diegovfeder/culltive/expo-app/src/image/profile.png

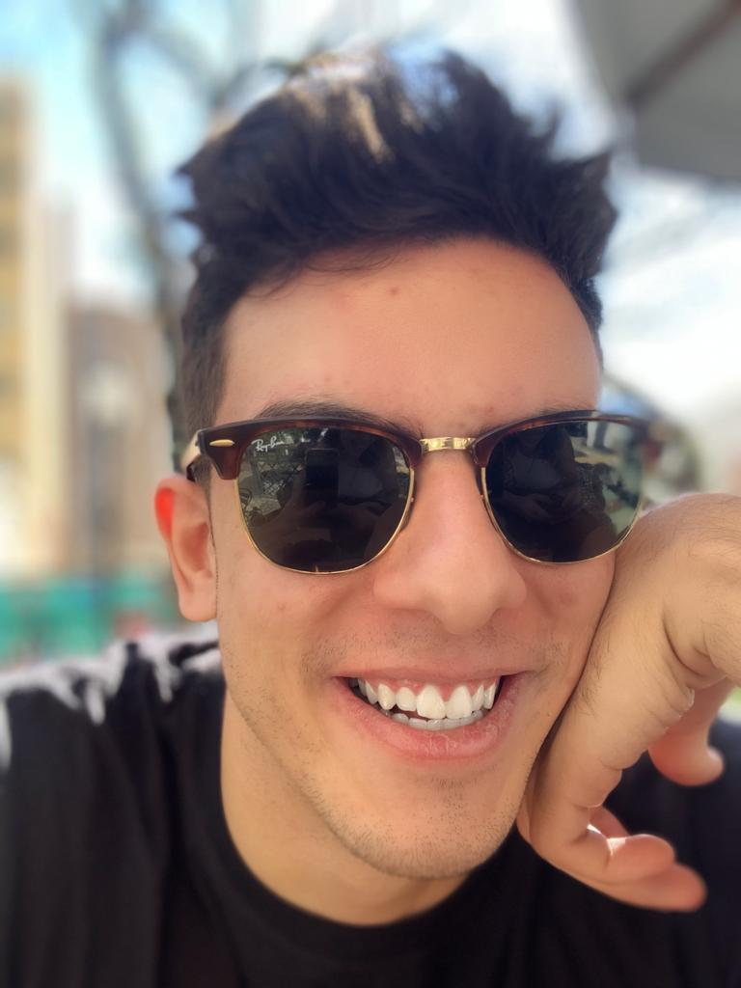
expo-app/src/image/profile.png
