diegovfeder/culltive/expo-app/src/image/acacia3.jpg

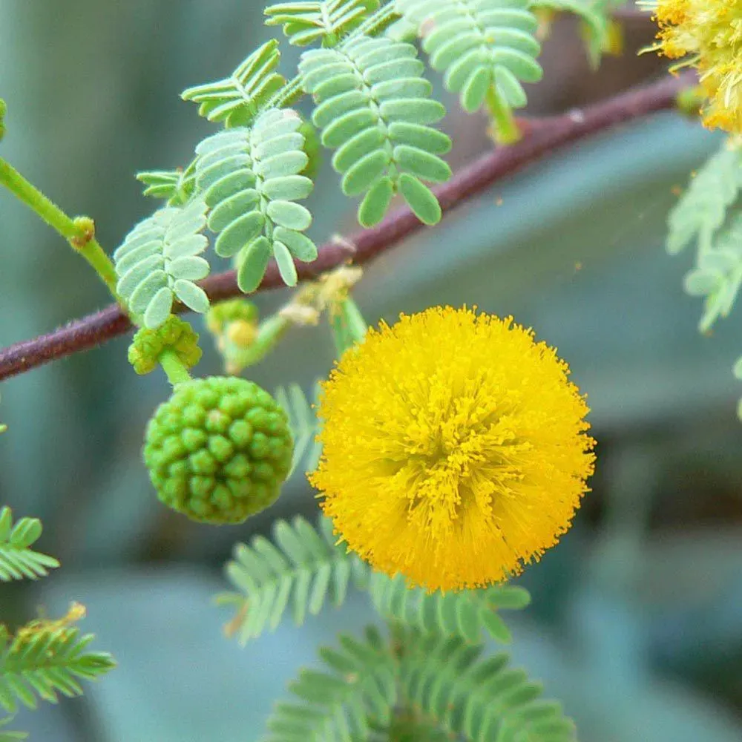
expo-app/src/image/acacia3.jpg
