diegovfeder/culltive/README.md

<h1 align="center">
    Culltive
</h1>

<h4 align="center">
  Culltive is a startup that combines technology, nature and decoration.
</h4>

<p align="center">
    <a href="#-Project">Project</a>&nbsp;&nbsp;&nbsp;|&nbsp;&nbsp;&nbsp;
    <a href="#rocket-Technology">Technology</a>&nbsp;&nbsp;&nbsp;
</p>

<br>

## 💻 Project

It was developed to solve the difficulties of maintaining gardens in urban environments, taking into account unfavorable spaces and the lack of time for the necessary care. 

## :rocket: Technology

This project was developed with the following technologies:

- [React](https://reactjs.org)
- [React Native](https://facebook.github.io/react-native/)
- [Expo](https://expo.io/)
- [Firebase](https://firebase.google.com/)
- [Platform.io](https://platformio.org/)

---
Startup engineered by Diego Feder
