diegovfeder/culltive/.misc/Especies Cultive 10 Agrourb.pdf

CARACTERÍSTICAS INERENTES DAS ESPÉCIES A SEREM UTILIZADAS

NO PROJETO CULTIVE

CURITIBA-PR

2019

SUMÁRIO

### 1 CULTIVE 10

1.1 CEBOLINHA (Allium fistulosum)

Ciclo de vida: perene

Altura máxima: 0,3 metros

Luminosidade: pleno sol e/ou meia sombra

Colheita: 30 dias após o plantio

Profundidade de semeadura: 0,5 cm

Espaçamento:

- Entre sementes – 2 cm
- Entre linhas – 5 cm

Luminosidade adequada: 5 horas de luz

Lux: 2450

FASES (dias): 30

Germinação: 0 – 10.°

Berçário: 11 – 17.°

Crescimento: 18 – 29.°

Colheita: 30.°

1.2 COENTRO (Coriandrum sativum)

Ciclo de vida: anual

Altura máxima: 0,6 metros

Luminosidade: pleno sol e/ou meia sombra

Colheita: 35 dias após o plantio

Profundidade de semeadura: 1,0 cm

Espaçamento:

- Entre sementes – 3 cm

- Entre linhas – 5 cm

Luminosidade adequada: 5 horas de luz

Lux: 2450

FASES (dias): 35

Germinação: 0 – 9.°

Berçário: 10 – 16.°

Crescimento: 17 – 34.°

Colheita: 35.°

1.3 MANJERICÃO (Ocimum basilicum)

Ciclo de vida: perene

Altura máxima: 1,5 metros

Luminosidade: pleno sol

Colheita: 35 dias após o plantio

Profundidade de semeadura: 0,5 cm

Espaçamento:

- Entre sementes – 5 cm
- Entre linhas – 5 cm

Luminosidade adequada: 5 horas de luz

Lux: 2450

FASES (dias): 35

Germinação: 0 – 7.°

Berçário: 8 – 14.°

Crescimento: 15 – 34.°

Colheita: 35.°

1.4 TOMILHO (Thymus vulgaris)

Ciclo de vida: Planta perene

Altura máxima: 0,3 metros

Luminosidade: pleno sol e/ou meia sombra

Colheita: 30 dias após o plantio

Profundidade de semeadura: 1,0 cm

Espaçamento:

- Entre sementes – 3 cm
- Entre linhas – 5 cm

Luminosidade adequada: 5 horas de luz

Lux: 2450

FASES (dias): 30

Germinação: 0 – 10.°

Berçário: 11 – 17.°

Crescimento: 18 – 29.°

Colheita: 30.°

1.5 ESPINAFRE (Spinacia oleracea)

Ciclo de vida: perene

Altura máxima: 0,35 metros

Luminosidade: pleno sol e/ou meia sombra

Colheita: 40 dias após o plantio

Profundidade de semeadura: 1,0 cm

Espaçamento:

- Entre sementes – 3 cm
- Entre linhas – 8 cm

Luminosidade adequada: 5 horas de luz

Lux: 2450

FASES (dias): 40

Germinação: 0 – 12.°

Berçário: 13 – 19.°

Crescimento: 20 – 39.°

Colheita: 40.°

1.6 RABANETE (Raphanus sativus)

Ciclo de vida: perene

Altura máxima: 0,35 metros

Luminosidade: pleno sol e/ou meia sombra

Colheita: 30 dias após o plantio

Profundidade de semeadura: 2,0 cm

Espaçamento:

- Entre sementes – 3 cm
- Entre linhas – 5 cm

Luminosidade adequada: 5 horas de luz

Lux: 2450

FASES (dias): 30

Germinação: 0 – 10.°

Berçário: 11 – 17.°

Crescimento: 18 – 29.°

Colheita: 30.°

1.7 ALFACE BABY LEAF (Lactuca sativa)

Ciclo de vida: perene

Altura máxima: 0,30 metros

Luminosidade: pleno sol e/ou meia sombra

Colheita: 35 dias após o plantio

Profundidade de semeadura: 1,0 cm

Espaçamento:

- Entre sementes – 6 cm
- Entre linhas - 8

Luminosidade adequada: 5 horas de luz

Lux: 2450

FASES (dias): 35

Germinação: 0 – 10.°

Berçário: 11 – 17.°

Crescimento: 18 – 34.°

Colheita: 35.°

1.8 AGRIÃO DA TERRA (Barbarea verna)

Ciclo de vida: perene

Altura máxima: 0,90 metros

Luminosidade: pleno sol e/ou meia sombra

Colheita: 25 dias após o plantio

Profundidade de semeadura: 0,5 cm

Espaçamento:

- Entre sementes – 1 cm
- Entre linhas – 3 cm

Luminosidade adequada: 5 horas de luz

Lux: 2450

FASES (dias): 25

Germinação: 0 – 7.°

Berçário: 8 – 14.°

Crescimento: 15 – 24.°

Colheita: 25.°

1.9 RÚCULA (Eruca sativa)

Ciclo de vida: perene

Altura máxima: 0,30 metros

Luminosidade: pleno sol e/ou meia sombra

Colheita: 35 dias após o plantio

Profundidade de semeadura: 0,5 cm

Espaçamento:

- Entre sementes – 5 cm
- Entre linhas – 8 cm

Luminosidade adequada: 5 horas de luz

Lux: 2450

FASES (dias): 35

Germinação: 0 – 5.°

Berçário: 6 – 12.°

Crescimento: 13 – 34.°

Colheita: 35.°

1.10 CENOURA BABY (Daucus carota sativus)

Ciclo de vida: bienal

Altura máxima: 0,35 metros

Luminosidade: pleno sol e/ou meia sombra

Colheita: 30 dias após o plantio

Profundidade de semeadura: 1,0 cm

Espaçamento:

- Entre sementes – 2 cm
- Entre linhas – 8 cm

Luminosidade adequada: 5 horas de luz

Lux: 2450

FASES (dias): 30

Germinação: 0 – 10.°

Berçário: 11 – 17.°

Crescimento: 18 – 29.°

Colheita: 30.°
