diegovfeder/culltive/react-dashboard/src/images/logos/Logo.pdf

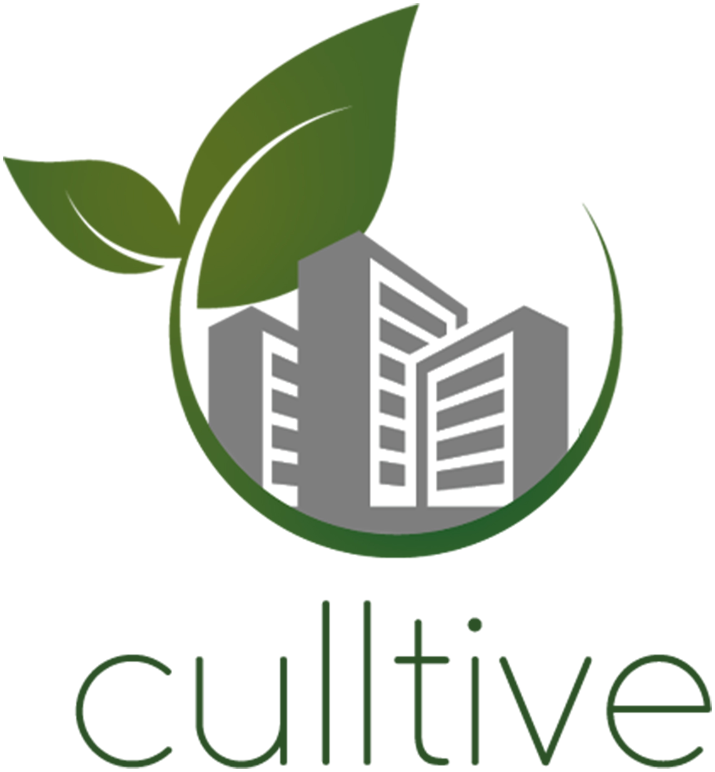
[picture p8: page 1]
