diegovfeder/culltive/.misc/chromecast wifi credentials.PNG

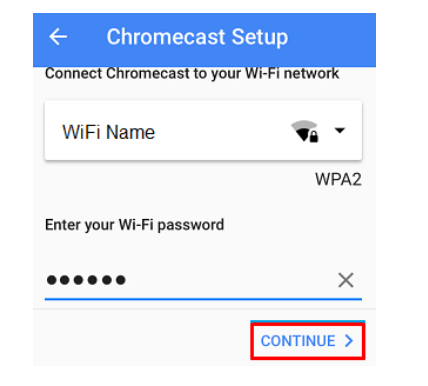
.misc/chromecast wifi credentials.PNG
