diegovfeder/culltive/.misc/ic_launcher/web_hi_res_512.png

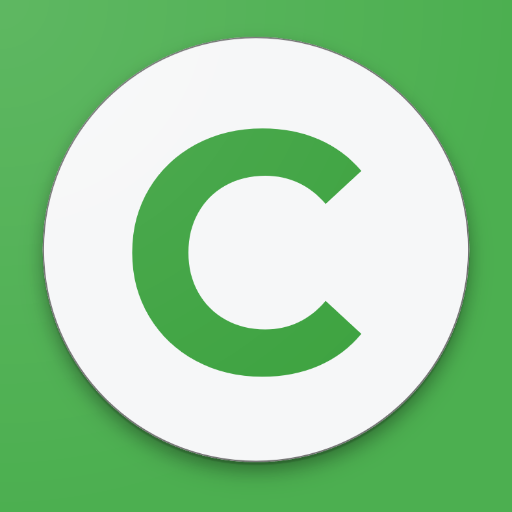
.misc/ic_launcher/web_hi_res_512.png
