diegovfeder/culltive/expo-app/src/image/acacia1.jpg

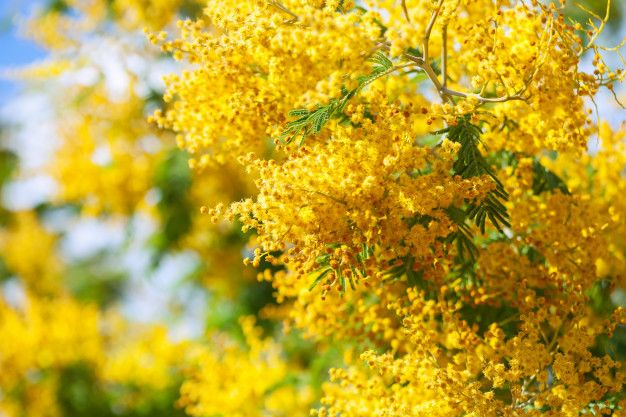
expo-app/src/image/acacia1.jpg
