diegovfeder/culltive/expo-app/src/image/acacia2.jpg

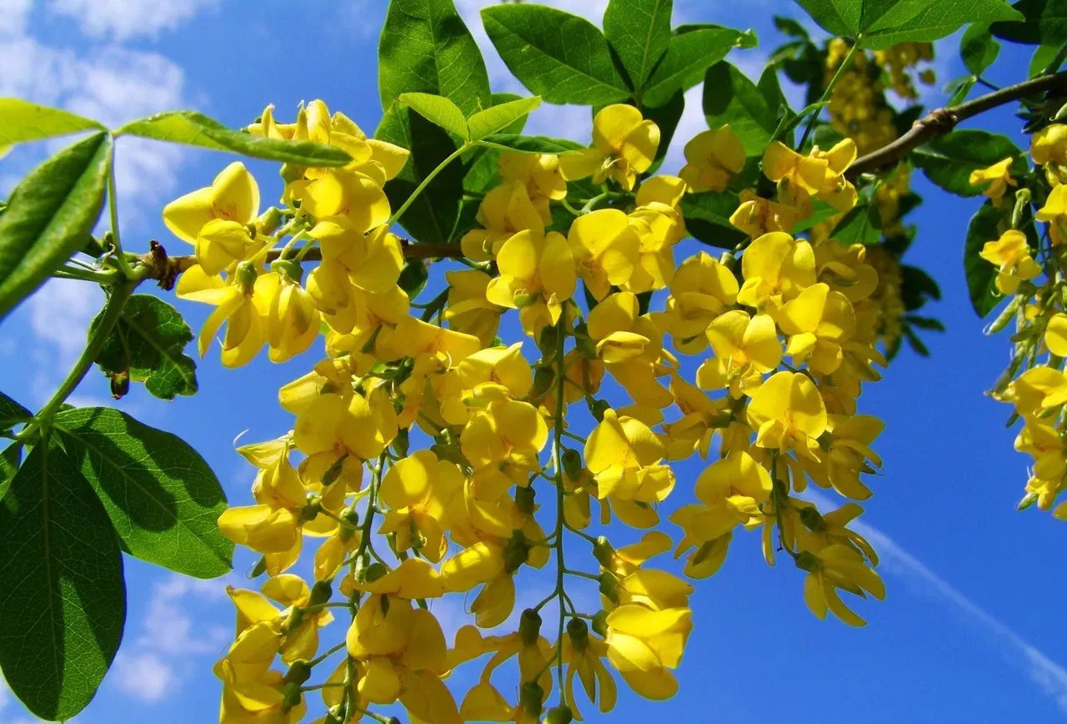
expo-app/src/image/acacia2.jpg
