diegovfeder/culltive/expo-app/src/image/acacia4.jpg

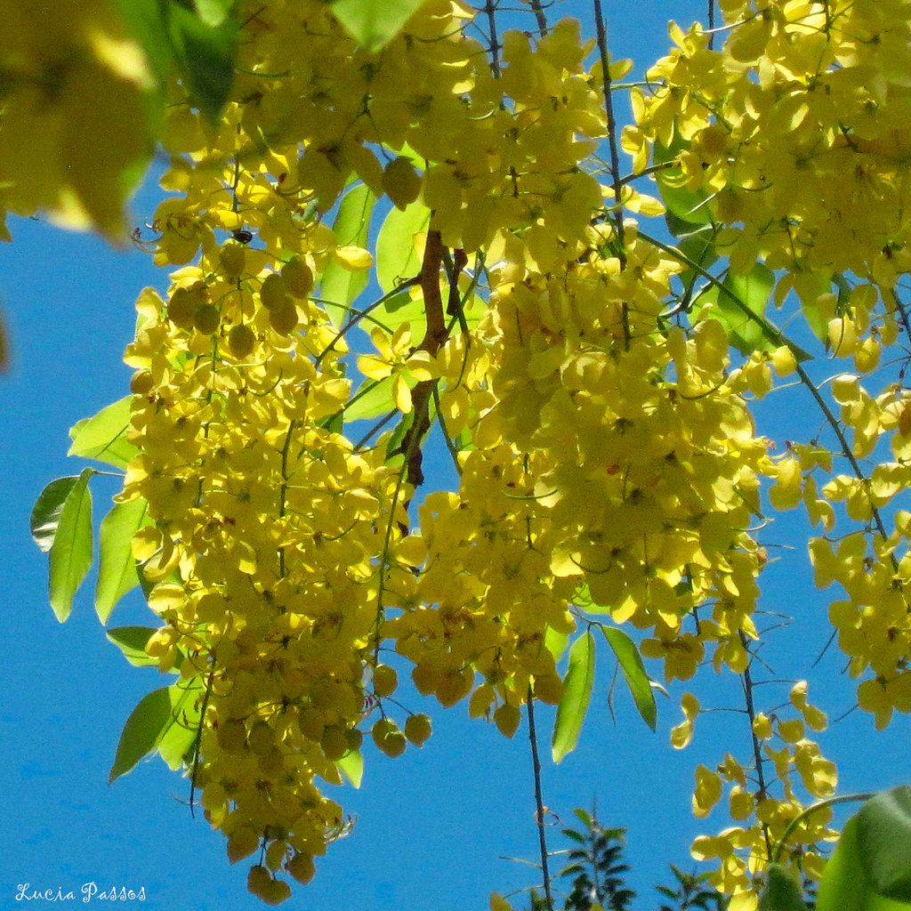
expo-app/src/image/acacia4.jpg
