diegovfeder/culltive/expo-app/src/image/eco-house.png

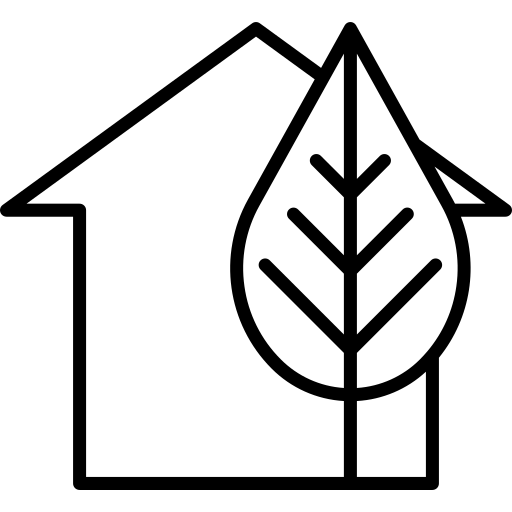
expo-app/src/image/eco-house.png
