diegovfeder/culltive/expo-app/src/image/leaves.png

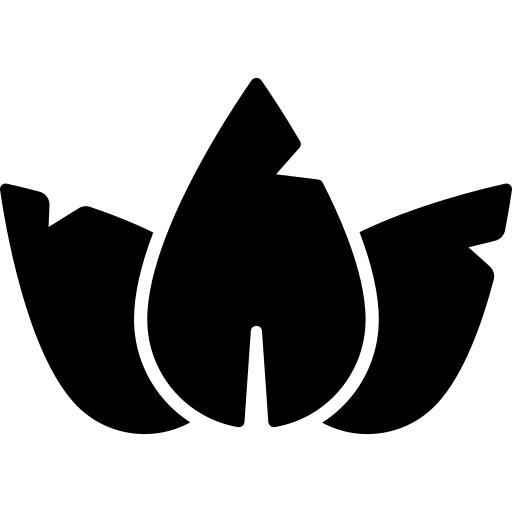
expo-app/src/image/leaves.png
