diegovfeder/culltive/expo-app/src/image/media1.jpg

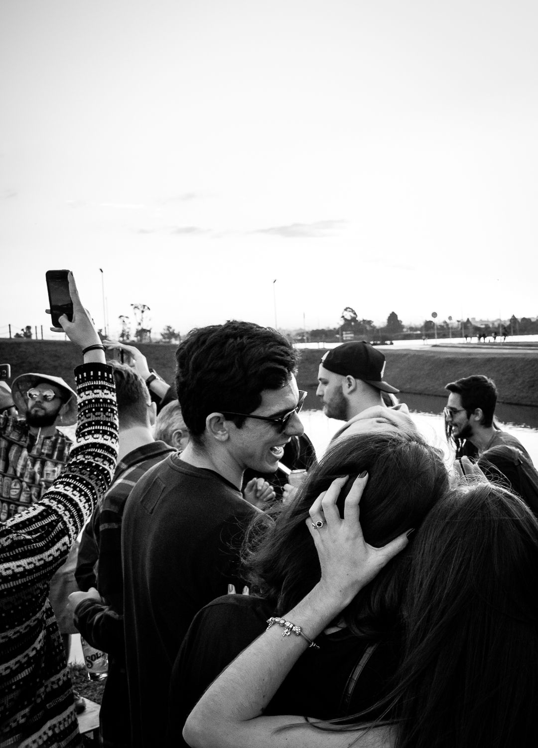
expo-app/src/image/media1.jpg
