diegovfeder/culltive/expo-app/src/image/media2.jpg

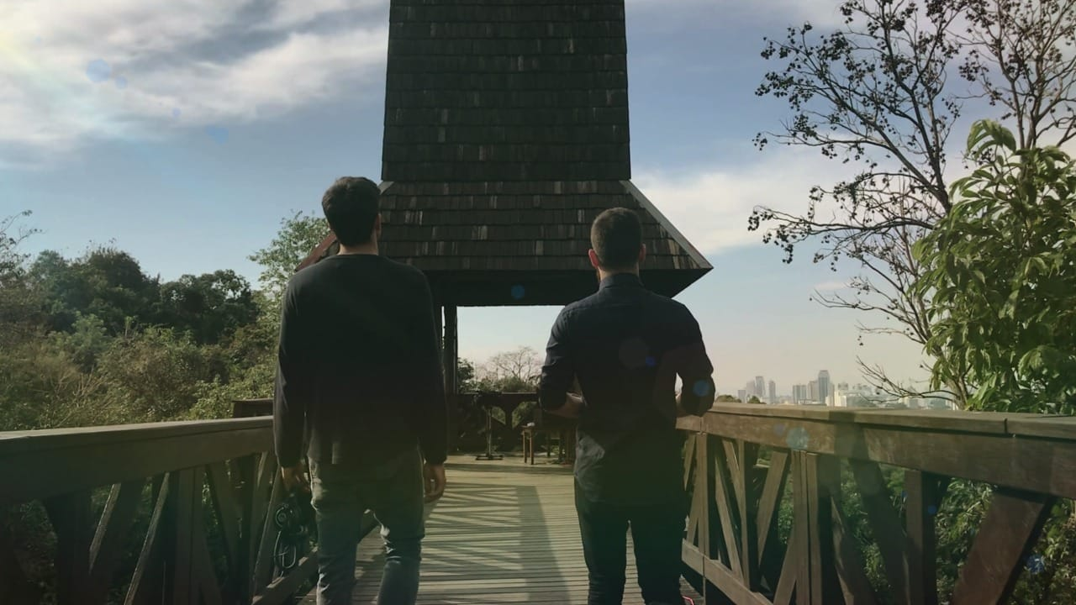
expo-app/src/image/media2.jpg
