diegovfeder/culltive/expo-app/src/image/media3.jpg

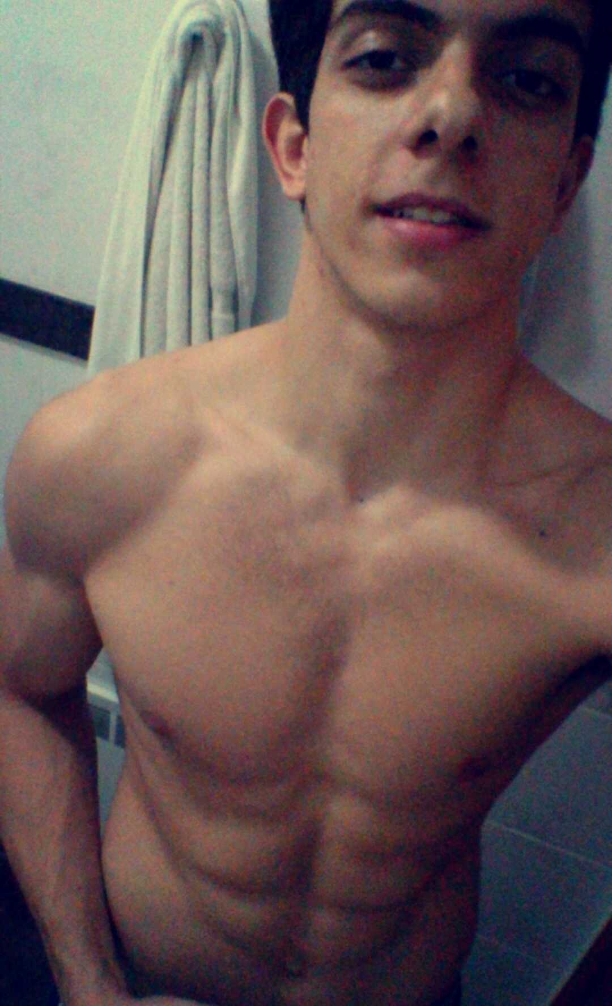
expo-app/src/image/media3.jpg
