diegovfeder/culltive/.misc/board/old_board/Projet.brd

## EAGLE design .misc/board/old_board/Projet.brd (2020-04-17, an earlier design)

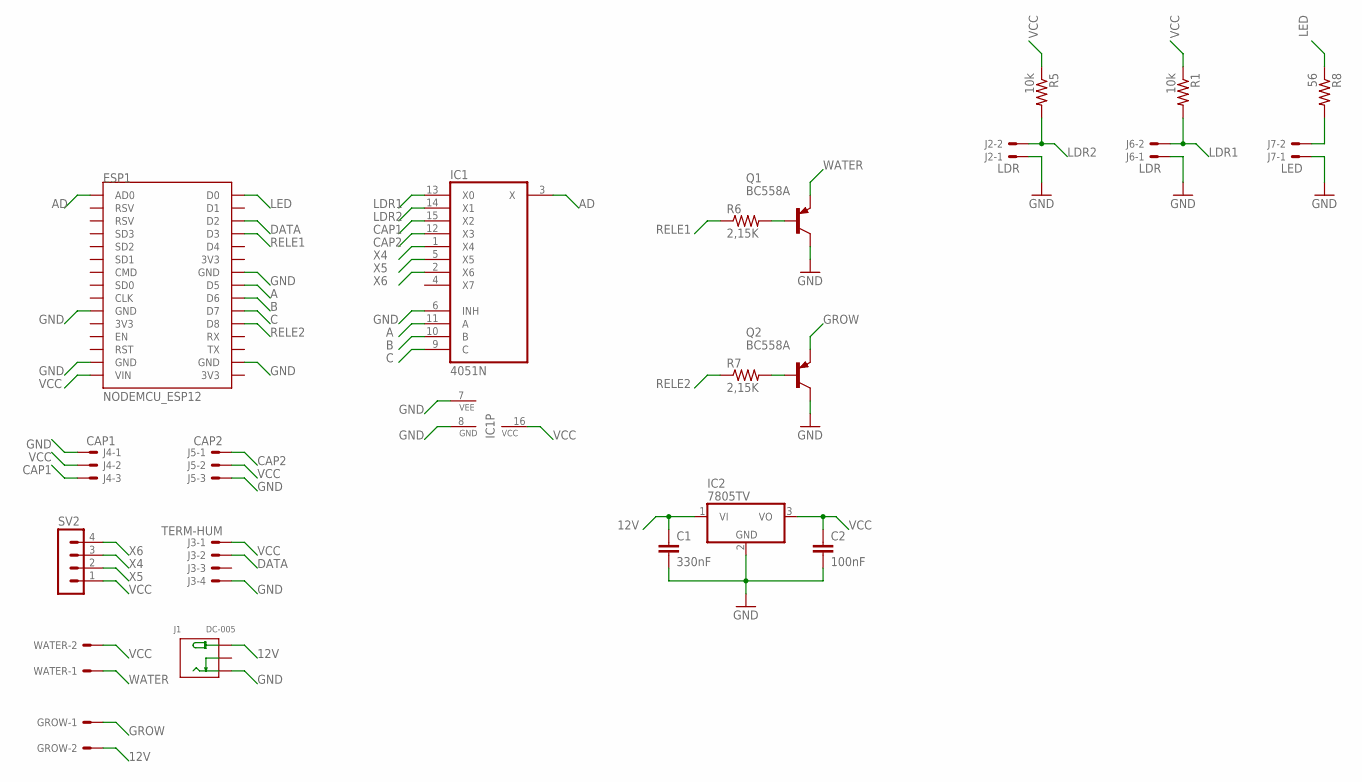
[picture p21: schematic Projet.sch]

Parts:
C1: 330nF; CAP_CERAMICO
C2: 100nF; CAP_CERAMICO
ESP1: NODEMCU_ESP12
GROW: KK-156-2
IC1: 4051N; DIL16
IC2: 7805TV; TO220V
J1: DC-005; DCJ3P-14.2X11.0X9.0MM
J2, J6: LDR; 7395-02
J3: TERM-HUM; 7395-04
J4: CAP1; 7395-03
J5: CAP2; 7395-03
J7: LED; 7395-02
Q1, Q2: BC558A; TO92-EBC
R1, R5: 10k; 0204/7
R6, R7: 2,15K; 0204/7
R8: 56; 0204/7
SV2: MA04-1
WATER: KK-156-2

Connections:
12V: C1.P$1 (1), GROW.2, IC2.1 (VI), J1.+
A: ESP1.D5, IC1.11 (A)
AD: ESP1.AD0, IC1.3 (X)
B: ESP1.D6, IC1.10 (B)
C: ESP1.D7, IC1.9 (C)
CAP1: IC1.15 (X2), J4.3
CAP2: IC1.12 (X3), J5.1
DATA: ESP1.D2, J3.2
GND: C1.P$2 (2), C2.P$2 (2), ESP1.GND@0 (GND), ESP1.GND@1 (GND), ESP1.GND@2 (GND), ESP1.GND@3 (GND), IC1.6 (INH), IC1.7 (VEE), IC1.8 (GND), IC2.2 (GND), J1.-1 (-), J2.1, J3.4, J4.1, J5.3, J6.1, J7.1, Q1.C, Q2.C
GROW: GROW.1, Q2.E
LDR1: IC1.13 (X0), J6.2, R1.2
LDR2: IC1.14 (X1), J2.2, R5.2
LED: ESP1.D0, R8.1
unnamed: J7.2, R8.2
unnamed: Q1.B, R6.2
unnamed: Q2.B, R7.2
RELE1: ESP1.D3, R6.1
RELE2: ESP1.D8, R7.1
VCC: C2.P$1 (1), ESP1.VIN, IC1.16 (VCC), IC2.3 (VO), J3.1, J4.2, J5.2, R1.1, R5.1, SV2.1, WATER.2
WATER: Q1.E, WATER.1
X4: IC1.1 (X4), SV2.3
X5: IC1.5 (X5), SV2.2
X6: IC1.2 (X6), SV2.4

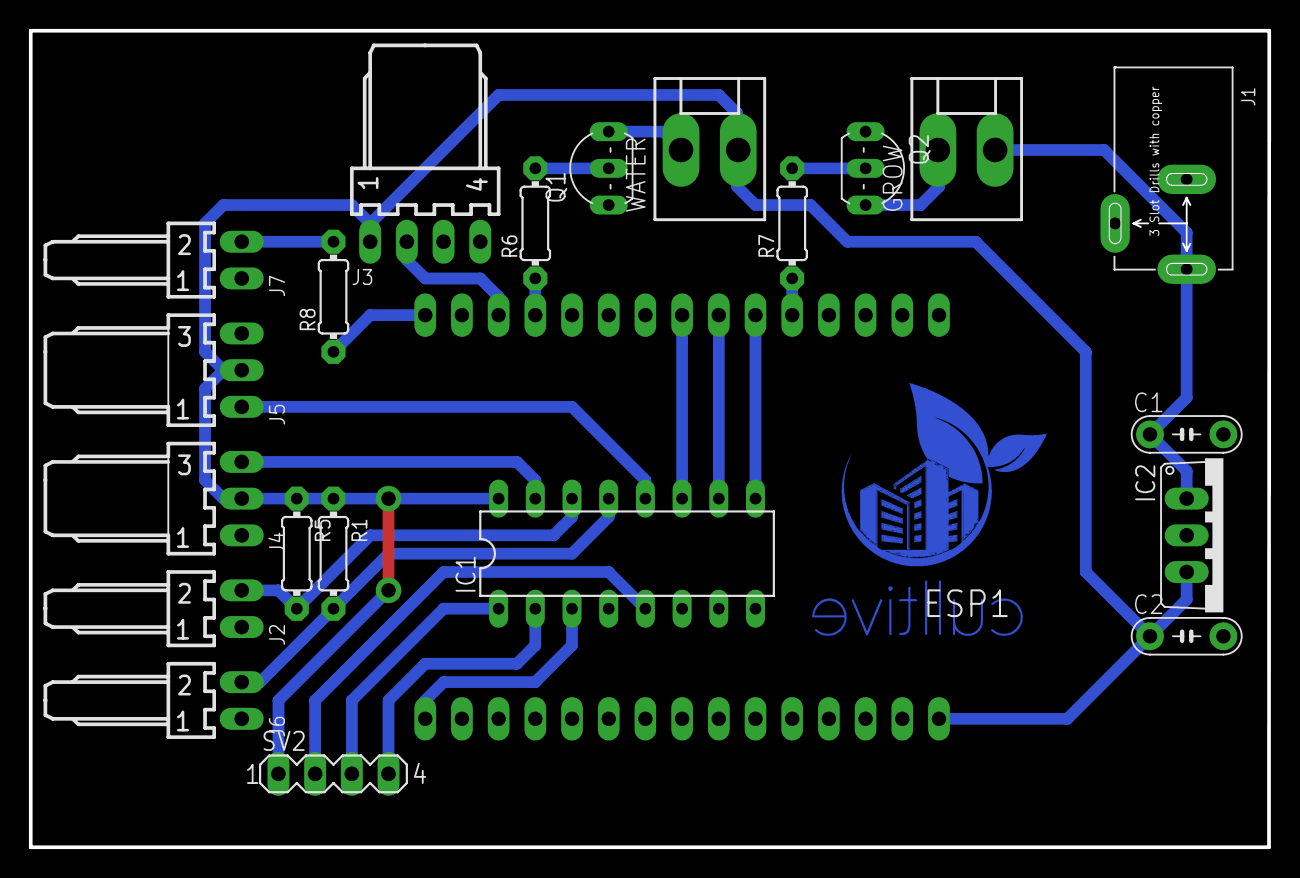
[picture p22: board Projet.brd from above]

Board: 2 copper layers, 85.7 x 56.5 mm, 22 parts (0 on the bottom side), 23 nets.
