diegovfeder/culltive/(commit log)

2020-04-17 Expo App Commit
    [Projet.brd, Projet.sch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]
2020-05-05 Add HomeScreen and Drawer
    fix Drawer Navigator button (navigate.toggleDrawer())
    fix Settings
    fix Drawer memory leak warning
    start AsyncStorage verification if app has already paired with a device
    - firsttime: Go to PairScreen (Ask for Permissions)
    - paired dvc: fetch data or pick a plant
2020-05-06 feat(PairNavigator) simplify and clean app flow
    - fix: react navigation is buggy // study and go
2020-05-11 feat (IOT Pair Device) uncompleted
2020-05-12 feat (sendData) axios sending data to iot device
2020-05-12 fix (Android Device)
2020-07-14 AppNavigator State Management and deviceActions
2020-07-16 Organized cloud-functions and developing deviceActions
